h-xh-git/STM32F407-Parking-System/bsp/OLED/oled_cn14.h

#ifndef __OLED_CN14_H__
#define __OLED_CN14_H__

/**
 * @file    oled_cn14.h
 * @brief   14x14 1bpp 中文字库（OLED 专用）
 *
 * 由 tools/gen_cn_font.py 自动生成，请勿手工修改。
 * 来源: LVGL v8 fmt-txt 4bpp 字体 font_chinese_14.h（simsun.ttf, size 14）
 * 共 112 个汉字，每个字 14x14 像素、28 字节，按 Unicode 升序二分查找。
 * 仅由 oled.c 包含，避免多份 static 数据占用 Flash。
 */

#include "stm32f4xx.h"

#define OLED_CN14_WIDTH       14
#define OLED_CN14_HEIGHT      14
#define OLED_CN14_BYTES       28

typedef struct {
    uint16_t unicode;   /* Unicode 码点 */
    uint16_t index;     /* 位图数组下标 */
} OLED_CN14_MapTypeDef;

/* 14 行 x 2 字节；每行 bit15..bit2 对应 x=0..13，1 表示点亮 */
static const uint8_t oled_cn14_bitmap[112][OLED_CN14_BYTES] = {
    { 0x00,0x00,0x00,0x00,0x00,0x00,0x00,0x00,0x00,0x00,0x00,0x00,0x00,0x00,0xFF,0xF8,0x00,0x00,0x00,0x00,0x00,0x00,0x00,0x00,0x00,0x00,0x00,0x00 }, /* U+4E00 一 */
    { 0x00,0x00,0x12,0x00,0x12,0x00,0x93,0xF0,0x94,0x80,0x94,0x40,0x98,0x40,0x90,0x00,0x97,0xF0,0x94,0x90,0x94,0x90,0x94,0x90,0x17,0xF0,0x14,0x10 }, /* U+4E34 临 */
    { 0x00,0x00,0x00,0x00,0x3F,0xE0,0x00,0x00,0x00,0x00,0x00,0x00,0xFF,0xF8,0x04,0x00,0x04,0x00,0x08,0x00,0x08,0x80,0x10,0x40,0x20,0x20,0x7F,0xF0 }, /* U+4E91 云 */
    { 0x00,0x00,0x04,0x00,0x02,0x00,0xFF,0xF8,0x00,0x00,0x3F,0xE0,0x20,0x20,0x20,0x20,0x20,0x20,0x3F,0xE0,0x02,0x00,0x12,0x40,0x22,0x20,0x42,0x10 }, /* U+4EAC 京 */
    { 0x00,0x00,0x11,0x00,0x10,0x80,0x10,0x80,0x27,0xF0,0x20,0x00,0x60,0x20,0xA4,0x20,0x24,0x20,0x22,0x20,0x22,0x40,0x22,0x40,0x20,0x40,0x20,0x80 }, /* U+4F4D 位 */
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
    { 0xBD, 0xF2, 0x6D25 }, /* 津 */
    { 0xBD, 0xFA, 0x664B }, /* 晋 */
    { 0xBD, 0xFB, 0x7981 }, /* 禁 */
    { 0xBE, 0xA9, 0x4EAC }, /* 京 */
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
};

#define OLED_GB2312_COUNT ((uint16_t)(sizeof(oled_gb2312_map) / sizeof(oled_gb2312_map[0])))

#endif /* __OLED_CN14_H__ */
