h-xh-git/STM32F407-Parking-System/bsp/RC522/bsp_rc522.c

#include "bsp_rc522.h"
#include "board.h"

/******************************************************************
 * 函 数 名 称：RC522_Init
 * 函 数 说 明：IC卡感应模块配置
 * 函 数 形 参：无
 * 函 数 返 回：无
 * 作       者：LC
 * 备       注：
******************************************************************/
void RC522_Init(void)
{          
        //开启时钟
        RCC_AHB1PeriphClockCmd(RCC_CS, ENABLE);                        
        RCC_AHB1PeriphClockCmd(RCC_SCK, ENABLE);        
        RCC_AHB1PeriphClockCmd(RCC_MOSI, ENABLE);        
        RCC_AHB1PeriphClockCmd(RCC_RST, ENABLE);        
        RCC_AHB1PeriphClockCmd(RCC_MISO, ENABLE);

        
        GPIO_InitTypeDef  GPIO_InitStructure;
        
        // CS
        GPIO_InitStructure.GPIO_Pin = GPIO_CS;
        GPIO_InitStructure.GPIO_Mode = GPIO_Mode_OUT;
        GPIO_InitStructure.GPIO_OType = GPIO_OType_PP;
        GPIO_InitStructure.GPIO_Speed = GPIO_Speed_50MHz;
        GPIO_InitStructure.GPIO_PuPd = GPIO_PuPd_UP;
        GPIO_Init(PORT_CS, &GPIO_InitStructure);
        GPIO_SetBits(PORT_CS, GPIO_CS);
        
        // SCK
        GPIO_InitStructure.GPIO_Pin = GPIO_SCK;
        GPIO_Init(PORT_SCK, &GPIO_InitStructure);
        GPIO_SetBits(PORT_SCK, GPIO_SCK);        
        
        // MOSI
        GPIO_InitStructure.GPIO_Pin = GPIO_MOSI;
        GPIO_Init(PORT_MOSI, &GPIO_InitStructure);
        GPIO_SetBits(PORT_MOSI, GPIO_MOSI);        
        
        // RST
        GPIO_InitStructure.GPIO_Pin = GPIO_RST;
        GPIO_Init(PORT_RST, &GPIO_InitStructure);
        GPIO_SetBits(PORT_RST, GPIO_RST);        

        // MISO
        GPIO_InitStructure.GPIO_Pin = GPIO_MISO;
        GPIO_InitStructure.GPIO_Mode = GPIO_Mode_IN;
        GPIO_InitStructure.GPIO_PuPd = GPIO_PuPd_NOPULL;
        GPIO_Init(PORT_MISO, &GPIO_InitStructure);

}



////////////////软件模拟SPI与RC522通信///////////////////////////////////////////
/* 软件模拟SPI发送一个字节数据，高位先行 */
void RC522_SPI_SendByte( uint8_t byte )
{
        uint8_t n;
        for( n=0;n<8;n++ )
        {
                if( byte&0x80 )
                        RC522_MOSI_1();
                else
                        RC522_MOSI_0();
                
                delay_us(5);
                RC522_SCK_0();
                delay_us(5);
                RC522_SCK_1();
                delay_us(5);
                
                byte<<=1;
        }
}

/* 软件模拟SPI读取一个字节数据，先读高位 */
uint8_t RC522_SPI_ReadByte( void )
{
        uint8_t n,data;
        for( n=0;n<8;n++ )
        {
                data<<=1;
                RC522_SCK_0();
                delay_us(5);
                
                if( RC522_MISO_GET()==1 )
                        data|=0x01;
                
                delay_us(5);
                RC522_SCK_1();
                delay_us(5);
                
                
        }
        return data;
}

//////////////////////////STM32对RC522寄存器的操作//////////////////////////////////
/*  读取RC522指定寄存器的值
    向RC522指定寄存器中写入指定的数据
    置位RC522指定寄存器的指定位
    清位RC522指定寄存器的指定位
*/

/**
  * @brief  ：读取RC522指定寄存器的值
        * @param  ：Address:寄存器的地址
  * @retval ：寄存器的值
*/
uint8_t RC522_Read_Register( uint8_t Address )
{
        uint8_t data,Addr;
        
        Addr = ( (Address<<1)&0x7E )|0x80;
        
        RC522_CS_Enable();
        RC522_SPI_SendByte( Addr );
        data = RC522_SPI_ReadByte();//读取寄存器中的值
        RC522_CS_Disable();
        
        return data;
}

/**
  * @brief  ：向RC522指定寄存器中写入指定的数据
  * @param  ：Address：寄存器地址
                                      data：要写入寄存器的数据
  * @retval ：无
*/
void RC522_Write_Register( uint8_t Address, uint8_t data )
{
        uint8_t Addr;
        
        Addr = ( Address<<1 )&0x7E;
        
        RC522_CS_Enable();
        RC522_SPI_SendByte( Addr );
        RC522_SPI_SendByte( data );
        RC522_CS_Disable();
        
}

/**
  * @brief  ：置位RC522指定寄存器的指定位
  * @param  ：Address：寄存器地址
                                      mask：置位值
  * @retval ：无
*/
void RC522_SetBit_Register( uint8_t Address, uint8_t mask )
{
        uint8_t temp;
        /* 获取寄存器当前值 */
        temp = RC522_Read_Register( Address );
        /* 对指定位进行置位操作后，再将值写入寄存器 */
        RC522_Write_Register( Address, temp|mask );
}

/**
  * @brief  ：清位RC522指定寄存器的指定位
  * @param  ：Address：寄存器地址
                      mask：清位值
  * @retval ：无
*/
void RC522_ClearBit_Register( uint8_t Address, uint8_t mask )
{
        uint8_t temp;
        /* 获取寄存器当前值 */
        temp = RC522_Read_Register( Address );
        /* 对指定位进行清位操作后，再将值写入寄存器 */
        RC522_Write_Register( Address, temp&(~mask) );
}

///////////////////STM32对RC522的基础通信///////////////////////////////////
/*
    开启天线
    关闭天线
    复位RC522
    设置RC522工作方式
*/

/**
  * @brief  ：开启天线
  * @param  ：无
  * @retval ：无
*/
void RC522_Antenna_On( void )
{
        uint8_t k;
        k = RC522_Read_Register( TxControlReg );
        /* 判断天线是否开启 */
        if( !( k&0x03 ) )
                RC522_SetBit_Register( TxControlReg, 0x03 );
}

/**
  * @brief  ：关闭天线
  * @param  ：无
  * @retval ：无
*/
void RC522_Antenna_Off( void )
{
        /* 直接对相应位清零 */
        RC522_ClearBit_Register( TxControlReg, 0x03 );
}


/**
  * @brief  ：复位RC522
  * @param  ：无
  * @retval ：无
*/
void RC522_Rese( void )
{
        RC522_Reset_Disable();
        delay_us ( 1 );
        RC522_Reset_Enable();
        delay_us ( 1 );
        RC522_Reset_Disable();
        delay_us ( 1 );
        RC522_Write_Register( CommandReg, 0x0F );
        /* 等待复位完成：加超时保护，避免 RC522 异常时死等 */
        {
                uint16_t ucReseTimeout = 2000;
                while( ( RC522_Read_Register( CommandReg ) & 0x10 ) && ( ucReseTimeout != 0 ) )
                {
                        ucReseTimeout --;
                }
        }

        /* 缓冲一下 */
        delay_us ( 1 );
        RC522_Write_Register( ModeReg, 0x3D );       //定义发送和接收常用模式
        RC522_Write_Register( TReloadRegL, 30 );     //16位定时器低位
        RC522_Write_Register( TReloadRegH, 0 );      //16位定时器高位
        RC522_Write_Register( TModeReg, 0x8D );      //内部定时器的设置
        RC522_Write_Register( TPrescalerReg, 0x3E ); //设置定时器分频系数
        RC522_Write_Register( TxAutoReg, 0x40 );     //调制发送信号为100%ASK
}


/**
  * @brief  ：设置RC522的工作方式
  * @param  ：Type：工作方式
  * @retval ：无
  M500PcdConfigISOType
*/
void RC522_Config_Type( char Type )
{
        if( Type=='A' )
        {
                RC522_ClearBit_Register( Status2Reg, 0x08 );
                RC522_Write_Register( ModeReg, 0x3D );
                RC522_Write_Register( RxSelReg, 0x86 );
                RC522_Write_Register( RFCfgReg, 0x7F );
                RC522_Write_Register( TReloadRegL, 30 );
                RC522_Write_Register( TReloadRegH, 0 );
                RC522_Write_Register( TModeReg, 0x8D );
                RC522_Write_Register( TPrescalerReg, 0x3E );
                delay_us(2);
                /* 开天线 */
                RC522_Antenna_On();
        }
}

/////////////////////////STM32控制RC522与M1卡的通信///////////////////////////////////////
/*
    通过RC522和M1卡通讯（数据的双向传输）
    寻卡
    防冲突
    用RC522计算CRC16（循环冗余校验）
    选定卡片
    校验卡片密码
    在M1卡的指定块地址写入指定数据
    读取M1卡的指定块地址的数据
    让卡片进入休眠模式
*/

/**
  * @brief  ：通过RC522和ISO14443卡通讯
* @param  ：ucCommand：RC522命令字
 *          pInData：通过RC522发送到卡片的数据
 *          ucInLenByte：发送数据的字节长度
 *          pOutData：接收到的卡片返回数据
 *          pOutLenBit：返回数据的位长度
  * @retval ：状态值MI_OK，成功
*/
char PcdComMF522 ( uint8_t ucCommand, uint8_t * pInData, uint8_t ucInLenByte, uint8_t * pOutData, uint32_t * pOutLenBit )                
{
    char cStatus = MI_ERR;
    uint8_t ucIrqEn   = 0x00;
    uint8_t ucWaitFor = 0x00;
    uint8_t ucLastBits;
    uint8_t ucN;
    uint32_t ul;
        
        
    switch ( ucCommand )
    {
       case PCD_AUTHENT:                //Mifare认证
          ucIrqEn   = 0x12;                //允许错误中断请求ErrIEn  允许空闲中断IdleIEn
          ucWaitFor = 0x10;                //认证寻卡等待时候 查询空闲中断标志位
          break;
                         
       case PCD_TRANSCEIVE:                //接收发送 发送接收
          ucIrqEn   = 0x77;                //允许TxIEn RxIEn IdleIEn LoAlertIEn ErrIEn TimerIEn
          ucWaitFor = 0x30;                //寻卡等待时候 查询接收中断标志位与 空闲中断标志位
          break;
                         
       default:
         break;
                         
    }
   
    RC522_Write_Register ( ComIEnReg, ucIrqEn | 0x80 );                //IRqInv置位管脚IRQ与Status1Reg的IRq位的值相反 
    RC522_ClearBit_Register ( ComIrqReg, 0x80 );                        //Set1该位清零时，CommIRqReg的屏蔽位清零
    RC522_Write_Register ( CommandReg, PCD_IDLE );                //写空闲命令
    RC522_SetBit_Register ( FIFOLevelReg, 0x80 );                        //置位FlushBuffer清除内部FIFO的读和写指针以及ErrReg的BufferOvfl标志位被清除
    
    for ( ul = 0; ul < ucInLenByte; ul ++ )
                  RC522_Write_Register ( FIFODataReg, pInData [ ul ] );                    //写数据进FIFOdata
                        
    RC522_Write_Register ( CommandReg, ucCommand );                                        //写命令
   
    
    if ( ucCommand == PCD_TRANSCEIVE )
                        RC522_SetBit_Register(BitFramingReg,0x80);                                  //StartSend置位启动数据发送 该位与收发命令使用时才有效
    
    ul = 1000;//根据时钟频率调整，操作M1卡最大等待时间25ms
                
    do                                                                                                                 //认证 与寻卡等待时间        
    {
         ucN = RC522_Read_Register ( ComIrqReg );                                                        //查询事件中断
         ul --;
    } while ( ( ul != 0 ) && ( ! ( ucN & 0x01 ) ) && ( ! ( ucN & ucWaitFor ) ) );                //退出条件i=0,定时器中断，与写空闲命令
                
    RC522_ClearBit_Register ( BitFramingReg, 0x80 );                                        //清理允许StartSend位
                
    if ( ul != 0 )
    {
                        if ( ! ( RC522_Read_Register ( ErrorReg ) & 0x1B ) )                        //读错误标志寄存器BufferOfI CollErr ParityErr ProtocolErr
                        {
                                cStatus = MI_OK;
                                
                                if ( ucN & ucIrqEn & 0x01 )                                        //是否发生定时器中断
                                  cStatus = MI_NOTAGERR;   
                                        
                                if ( ucCommand == PCD_TRANSCEIVE )
                                {
                                        ucN = RC522_Read_Register ( FIFOLevelReg );                        //读FIFO中保存的字节数
                                        
                                        ucLastBits = RC522_Read_Register ( ControlReg ) & 0x07;        //最后接收到得字节的有效位数
                                        
                                        if ( ucLastBits )
                                                * pOutLenBit = ( ucN - 1 ) * 8 + ucLastBits;           //N个字节数减去1（最后一个字节）+最后一位的位数 读取到的数据总位数
                                        else
                                                * pOutLenBit = ucN * 8;                                           //最后接收到的字节整个字节有效
                                        
                                        if ( ucN == 0 )                
            ucN = 1;    
                                        
                                        if ( ucN > MAXRLEN )
                                                ucN = MAXRLEN;   
                                        
                                        for ( ul = 0; ul < ucN; ul ++ )
                                          pOutData [ ul ] = RC522_Read_Register ( FIFODataReg );                                           
                                        }                                        
      }                        
                        else
                                cStatus = MI_ERR;                           
    }
   
   RC522_SetBit_Register ( ControlReg, 0x80 );           // stop timer now
   RC522_Write_Register ( CommandReg, PCD_IDLE ); 
                 
   return cStatus;                
}



/**
  * @brief  ：寻卡
* @param  ucReq_code，寻卡方式
*                      = 0x52：寻感应区内所有符合14443A标准的卡
 *                     = 0x26：寻未进入休眠状态的卡
 *         pTagType，卡片类型代码
 *                   = 0x4400：Mifare_UltraLight
 *                   = 0x0400：Mifare_One(S50)
 *                   = 0x0200：Mifare_One(S70)
 *                   = 0x0800：Mifare_Pro(X))
 *                   = 0x4403：Mifare_DESFire
  * @retval ：状态值MI_OK，成功
*/
char PcdRequest ( uint8_t ucReq_code, uint8_t * pTagType )
{
   char cStatus;  
   uint8_t ucComMF522Buf [ MAXRLEN ]; 
   uint32_t ulLen;
        
   RC522_ClearBit_Register ( Status2Reg, 0x08 );        //清理指示MIFARECyptol单元接通以及所有卡的数据通信被加密的情况
   RC522_Write_Register ( BitFramingReg, 0x07 );        //        发送的最后一个字节的 七位
   RC522_SetBit_Register ( TxControlReg, 0x03 );        //TX1,TX2管脚的输出信号传递经发送调制的13.46的能量载波信号

   ucComMF522Buf [ 0 ] = ucReq_code;                //存入寻卡方式
        /* PCD_TRANSCEIVE：发送并接收数据的命令，RC522向卡片发送寻卡命令，卡片返回卡的型号代码到ucComMF522Buf中 */
   cStatus = PcdComMF522 ( PCD_TRANSCEIVE,        ucComMF522Buf, 1, ucComMF522Buf, & ulLen );        //寻卡  
  
   if ( ( cStatus == MI_OK ) && ( ulLen == 0x10 ) )        //寻卡成功返回卡类型 
   {    
                 /* 接收卡片的型号代码 */
       * pTagType = ucComMF522Buf [ 0 ];
       * ( pTagType + 1 ) = ucComMF522Buf [ 1 ];
   }
   else
   {
     cStatus = MI_ERR;
   }

   return cStatus;
}



/**
  * @brief  ：防冲突
        * @param  ：Snr：卡片序列，4字节，会返回选中卡片的序列
  * @retval ：状态值MI_OK，成功
*/
char PcdAnticoll ( uint8_t * pSnr )
{
    char cStatus;
    uint8_t uc, ucSnr_check = 0;
    uint8_t ucComMF522Buf [ MAXRLEN ]; 
          uint32_t ulLen;
   
    RC522_ClearBit_Register ( Status2Reg, 0x08 );                //清MFCryptol On位 只有成功执行MFAuthent命令后，该位才能置位
    RC522_Write_Register ( BitFramingReg, 0x00);                //清理寄存器 停止收发
    RC522_ClearBit_Register ( CollReg, 0x80 );                        //清ValuesAfterColl所有接收的位在冲突后被清除
   
    ucComMF522Buf [ 0 ] = 0x93;        //卡片防冲突命令
    ucComMF522Buf [ 1 ] = 0x20;
   
          /* 将卡片防冲突命令通过RC522传到卡片中，返回的是被选中卡片的序列 */
    cStatus = PcdComMF522 ( PCD_TRANSCEIVE, ucComMF522Buf, 2, ucComMF522Buf, & ulLen);//与卡片通信
        
    if ( cStatus == MI_OK)                //通信成功
    {
                        for ( uc = 0; uc < 4; uc ++ )
                        {
         * ( pSnr + uc )  = ucComMF522Buf [ uc ];                        //读出UID
         ucSnr_check ^= ucComMF522Buf [ uc ];
      }
                        
      if ( ucSnr_check != ucComMF522Buf [ uc ] )
                                cStatus = MI_ERR;             
    }    
    RC522_SetBit_Register ( CollReg, 0x80 );                
    return cStatus;                
}



/**
 * @brief   :用RC522计算CRC16（循环冗余校验）
        * @param  ：pIndata：计算CRC16的数组
 *            ucLen：计算CRC16的数组字节长度
 *            pOutData：存放计算结果存放的首地址
  * @retval ：状态值MI_OK，成功
*/
void CalulateCRC ( uint8_t * pIndata, u8 ucLen, uint8_t * pOutData )
{
    uint8_t uc, ucN;
        
        
    RC522_ClearBit_Register(DivIrqReg,0x04);        
    RC522_Write_Register(CommandReg,PCD_IDLE);        
    RC522_SetBit_Register(FIFOLevelReg,0x80);
        
    for ( uc = 0; uc < ucLen; uc ++)
            RC522_Write_Register ( FIFODataReg, * ( pIndata + uc ) );   

    RC522_Write_Register ( CommandReg, PCD_CALCCRC );
        
    uc = 0xFF;
        
    do 
    {
        ucN = RC522_Read_Register ( DivIrqReg );
        uc --;
    } while ( ( uc != 0 ) && ! ( ucN & 0x04 ) );
                
    pOutData [ 0 ] = RC522_Read_Register ( CRCResultRegL );
    pOutData [ 1 ] = RC522_Read_Register ( CRCResultRegM );
                
}



/**
  * @brief   :选定卡片并输出 SAK
  * @param  ：pSnr：卡片序列号，4字节（输入）
  *           pSak：输出参数，卡片 SAK（接收缓冲区第 0 字节）；可为 NULL
 * @retval ：状态值MI_OK，成功
  * @note   ：PcdComMF522 结束时已经把响应读进 ucComMF522Buf，SAK 就是它的第 0 字节；
  *           不能再从 FIFODataReg 读（FIFO 已读空，读出来恒为 0）。
*/
char PcdSelectEx ( uint8_t * pSnr, uint8_t * pSak )
{
    char cStatus;
    uint8_t uc;
    uint8_t ucComMF522Buf [ MAXRLEN ];
    uint32_t ulLen;

    if ( pSnr == 0 )
    {
        return MI_ERR;
    }

    /* PICC_ANTICOLL1：防冲突命令 */
    ucComMF522Buf [ 0 ] = PICC_ANTICOLL1;
    ucComMF522Buf [ 1 ] = 0x70;
    ucComMF522Buf [ 6 ] = 0;

    for ( uc = 0; uc < 4; uc ++ )
    {
        ucComMF522Buf [ uc + 2 ] = * ( pSnr + uc );
        ucComMF522Buf [ 6 ] ^= * ( pSnr + uc );
    }

    CalulateCRC ( ucComMF522Buf, 7, & ucComMF522Buf [ 7 ] );

    RC522_ClearBit_Register ( Status2Reg, 0x08 );

    cStatus = PcdComMF522 ( PCD_TRANSCEIVE, ucComMF522Buf, 9, ucComMF522Buf, & ulLen );

    if ( ( cStatus == MI_OK ) && ( ulLen == 0x18 ) )
    {
        if ( pSak != 0 )
        {
            * pSak = ucComMF522Buf [ 0 ];   /* SAK = 接收缓冲区第 0 字节 */
        }
    }
    else
    {
        cStatus = MI_ERR;
    }

    return cStatus;
}

/**
  * @brief   :选定卡片（兼容旧接口，丢弃 SAK）
  * @param  ：pSnr：卡片序列号，4字节
 * @retval ：状态值MI_OK，成功
*/
char PcdSelect ( uint8_t * pSnr )
{
    return PcdSelectEx ( pSnr, 0 );
}



/**
  * @brief   :校验卡片密码
  * @param  ：ucAuth_mode：密码验证模式
  *                     = 0x60，验证A密钥
  *                     = 0x61，验证B密钥
  *           ucAddr：块地址
  *           pKey：密码，6字节
  *           pSnr：卡片序列号，4字节（Mifare 认证只使用前 4 字节，禁止越界读 6 字节）
 * @retval ：状态值MI_OK，成功
*/
char PcdAuthState ( uint8_t ucAuth_mode, uint8_t ucAddr, uint8_t * pKey, uint8_t * pSnr )
{
    char cStatus;
    uint8_t uc, ucComMF522Buf [ MAXRLEN ];
    uint32_t ulLen;

    if ( ( pKey == 0 ) || ( pSnr == 0 ) )
    {
        return MI_ERR;
    }

    ucComMF522Buf [ 0 ] = ucAuth_mode;
    ucComMF522Buf [ 1 ] = ucAddr;

    /* 2~7 字节：6 字节密码 */
    for ( uc = 0; uc < 6; uc ++ )
    {
        ucComMF522Buf [ uc + 2 ] = * ( pKey + uc );
    }

    /* 8~11 字节：4 字节 UID（认证命令总长 12 字节） */
    for ( uc = 0; uc < 4; uc ++ )
    {
        ucComMF522Buf [ uc + 8 ] = * ( pSnr + uc );
    }

    cStatus = PcdComMF522 ( PCD_AUTHENT, ucComMF522Buf, 12, ucComMF522Buf, & ulLen );

    if ( ( cStatus != MI_OK ) || ( ! ( RC522_Read_Register ( Status2Reg ) & 0x08 ) ) )
    {
        cStatus = MI_ERR;
    }

    return cStatus;
}


/**
  * @brief   :在M1卡的指定块地址写入指定数据
  * @param  ：ucAddr：块地址
  *           pData：写入的数据，16字节
  * @retval ：状态值MI_OK，成功
*/
char PcdWrite ( uint8_t ucAddr, uint8_t * pData )
{
    char cStatus;
          uint8_t uc, ucComMF522Buf [ MAXRLEN ];
    uint32_t ulLen;
   
    ucComMF522Buf [ 0 ] = PICC_WRITE;//写块命令
    ucComMF522Buf [ 1 ] = ucAddr;//写块地址
        
          /* 进行循环冗余校验，将结果存储在& ucComMF522Buf [ 2 ] */
    CalulateCRC ( ucComMF522Buf, 2, & ucComMF522Buf [ 2 ] );
    
        /* PCD_TRANSCEIVE:发送并接收数据命令，通过RC522向卡片发送写块命令 */
    cStatus = PcdComMF522 ( PCD_TRANSCEIVE, ucComMF522Buf, 4, ucComMF522Buf, & ulLen );

                /* 通过卡片返回的信息判断，RC522是否与卡片正常通信 */
    if ( ( cStatus != MI_OK ) || ( ulLen != 4 ) || ( ( ucComMF522Buf [ 0 ] & 0x0F ) != 0x0A ) )
      cStatus = MI_ERR;   
        
    if ( cStatus == MI_OK )
    {
                        //memcpy(ucComMF522Buf, pData, 16);
                        /* 将要写入的16字节的数据，传入ucComMF522Buf数组中 */
      for ( uc = 0; uc < 16; uc ++ )
                          ucComMF522Buf [ uc ] = * ( pData + uc );  
                        /* 冗余校验 */
      CalulateCRC ( ucComMF522Buf, 16, & ucComMF522Buf [ 16 ] );
      /* 通过RC522，将16字节数据包括2字节校验结果写入卡片中 */
      cStatus = PcdComMF522 ( PCD_TRANSCEIVE, ucComMF522Buf, 18, ucComMF522Buf, & ulLen );
                        /* 判断写地址是否成功 */
                        if ( ( cStatus != MI_OK ) || ( ulLen != 4 ) || ( ( ucComMF522Buf [ 0 ] & 0x0F ) != 0x0A ) )
        cStatus = MI_ERR;                           
    } 
    return cStatus;        
}


/**
  * @brief   :读取M1卡的指定块地址的数据
  * @param  ：ucAddr：块地址
  *           pData：读出的数据，16字节
  * @retval ：状态值MI_OK，成功
*/
char PcdRead ( uint8_t ucAddr, uint8_t * pData )
{
    char cStatus;
          uint8_t uc, ucComMF522Buf [ MAXRLEN ]; 
    uint32_t ulLen;

    ucComMF522Buf [ 0 ] = PICC_READ;
    ucComMF522Buf [ 1 ] = ucAddr;
          /* 冗余校验 */
    CalulateCRC ( ucComMF522Buf, 2, & ucComMF522Buf [ 2 ] );
    /* 通过RC522将命令传给卡片 */
    cStatus = PcdComMF522 ( PCD_TRANSCEIVE, ucComMF522Buf, 4, ucComMF522Buf, & ulLen );
        
          /* 如果传输正常，将读取到的数据传入pData中 */
    if ( ( cStatus == MI_OK ) && ( ulLen == 0x90 ) )
    {
                        for ( uc = 0; uc < 16; uc ++ )
        * ( pData + uc ) = ucComMF522Buf [ uc ];   
    }
    else
      cStatus = MI_ERR;   
        
    return cStatus;

}


/**
  * @brief   :让卡片进入休眠模式
  * @param  ：无
  * @retval ：状态值MI_OK，成功
*/
char PcdHalt( void )
{
        uint8_t ucComMF522Buf [ MAXRLEN ]; 
        uint32_t  ulLen;

  ucComMF522Buf [ 0 ] = PICC_HALT;
  ucComMF522Buf [ 1 ] = 0;
        
  CalulateCRC ( ucComMF522Buf, 2, & ucComMF522Buf [ 2 ] );
         PcdComMF522 ( PCD_TRANSCEIVE, ucComMF522Buf, 4, ucComMF522Buf, & ulLen );

  return MI_OK;
        
}

char PcdUltralightRead ( uint8_t ucPage, uint8_t * pData )
{
    char cStatus;
    uint8_t uc, ucComMF522Buf [ MAXRLEN ]; 
    uint32_t ulLen;

    ucComMF522Buf [ 0 ] = PICC_READ;
    ucComMF522Buf [ 1 ] = ucPage;
    CalulateCRC ( ucComMF522Buf, 2, & ucComMF522Buf [ 2 ] );
    cStatus = PcdComMF522 ( PCD_TRANSCEIVE, ucComMF522Buf, 4, ucComMF522Buf, & ulLen );
        
    if ( ( cStatus == MI_OK ) && ( ulLen == 0x90 ) )
    {
        for ( uc = 0; uc < 4; uc ++ )
            * ( pData + uc ) = ucComMF522Buf [ uc ];   
    }
    else
        cStatus = MI_ERR;   
        
    return cStatus;
}

char PcdUltralightWrite ( uint8_t ucPage, uint8_t * pData )
{
    char cStatus;
    uint8_t uc, ucComMF522Buf [ MAXRLEN ]; 
    uint32_t ulLen;

    ucComMF522Buf [ 0 ] = PICC_WRITE;
    ucComMF522Buf [ 1 ] = ucPage;
    CalulateCRC ( ucComMF522Buf, 2, & ucComMF522Buf [ 2 ] );
    cStatus = PcdComMF522 ( PCD_TRANSCEIVE, ucComMF522Buf, 4, ucComMF522Buf, & ulLen );
        
    if ( ( cStatus != MI_OK ) || ( ulLen != 4 ) || ( ( ucComMF522Buf [ 0 ] & 0x0F ) != 0x0A ) )
        cStatus = MI_ERR;   
        
    if ( cStatus == MI_OK )
    {
        for ( uc = 0; uc < 4; uc ++ )
            ucComMF522Buf [ uc ] = * ( pData + uc );  
        CalulateCRC ( ucComMF522Buf, 4, & ucComMF522Buf [ 4 ] );
        cStatus = PcdComMF522 ( PCD_TRANSCEIVE, ucComMF522Buf, 6, ucComMF522Buf, & ulLen );
        if ( ( cStatus != MI_OK ) || ( ulLen != 4 ) || ( ( ucComMF522Buf [ 0 ] & 0x0F ) != 0x0A ) )
            cStatus = MI_ERR;                           
    } 
    return cStatus;
}
